maxeo/3dprint-sakura/README.md

# Sakura

Pannello decorativo 410 × 520 × 7 mm stampato in 3D, diviso in 6 moduli uniti da 21 perni Ø3,42 mm.

**Guida di stampa e montaggio:** https://maxeo.github.io/3dprint-guide/sakura/guida.html

La guida online è una copia pubblica di [guida.html](guida.html), pubblicata dal repo
[3dprint-guide](https://github.com/maxeo/3dprint-guide).

## Contenuto

- `guida.html`, `documenti/LEGGIMI_STAMPA_E_MONTAGGIO.txt`, `documenti/mappa_montaggio.svg`: istruzioni e impostazioni di stampa
- `dati/guida_spec.json`: sorgente di `guida.html`, da rigenerare con `build_guide.py` della skill guida-stampa-3d
- `stl/P01`…`P06_*_7mm.stl`: moduli, una copia ciascuno
- `stl/PERNO_D3.42_L15_stampare_21_copie.stl`: perno, 21 copie (in `stl/` anche le varianti Ø3,45–3,55)
- `prove/`: provini e giunto usati per tarare le sedi
- `originale/`: pannello intero prima della divisione
