maxeo/3dprint-sakura/originale/scaffale_sakura_ricreato_410x520x10mm.stl

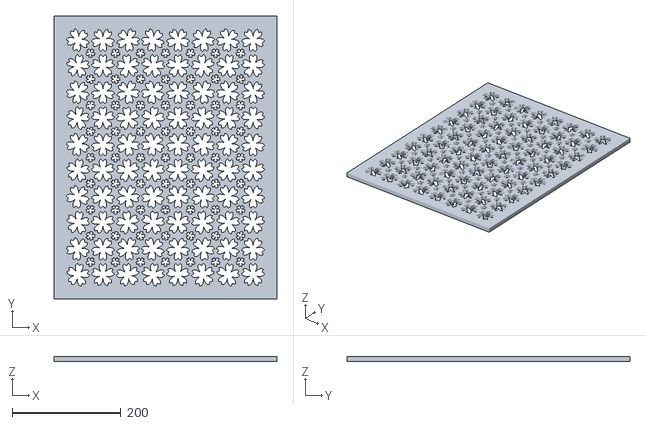
[picture p1: CAD file, 2026-09-12]
originale/scaffale_sakura_ricreato_410x520x10mm.stl
410.0 x 520.0 x 10.0
