maxeo/3dprint-sakura/prove/Sakura_provino_A_chiuso_H10_D605.stl

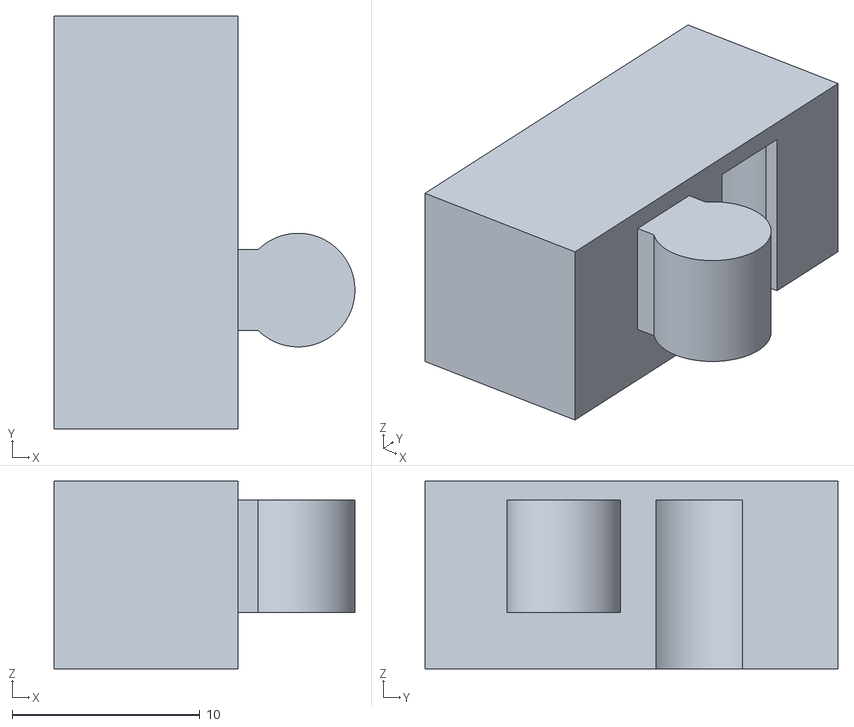
[picture p2: CAD file, 2026-09-12]
prove/Sakura_provino_A_chiuso_H10_D605.stl
16.0 x 22.0 x 10.0
