maxeo/3dprint-sakura/stl/PERNO_D3.55_L15_stampare_21_copie.stl

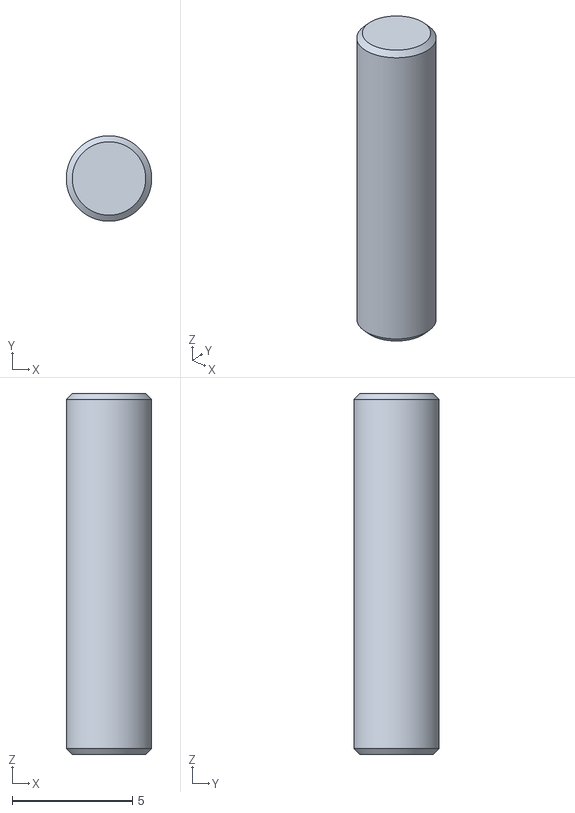
[picture p3: CAD file, 2026-09-26]
stl/PERNO_D3.55_L15_stampare_21_copie.stl
3.55 x 3.55 x 15.0
