maxeo/3dprint-sakura/prove/Sakura_giunto_2cubi10_perno_D3_L15.stl

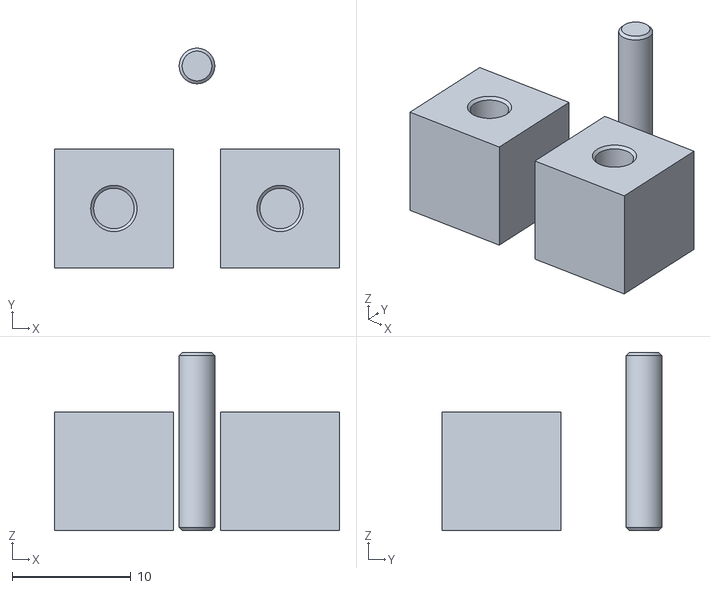
[picture p4: CAD file, 2026-09-12]
prove/Sakura_giunto_2cubi10_perno_D3_L15.stl
24.0 x 18.5 x 15.0
