maxeo/3dprint-sakura/stl/PERNO_D3.42_L15_stampare_21_copie.stl

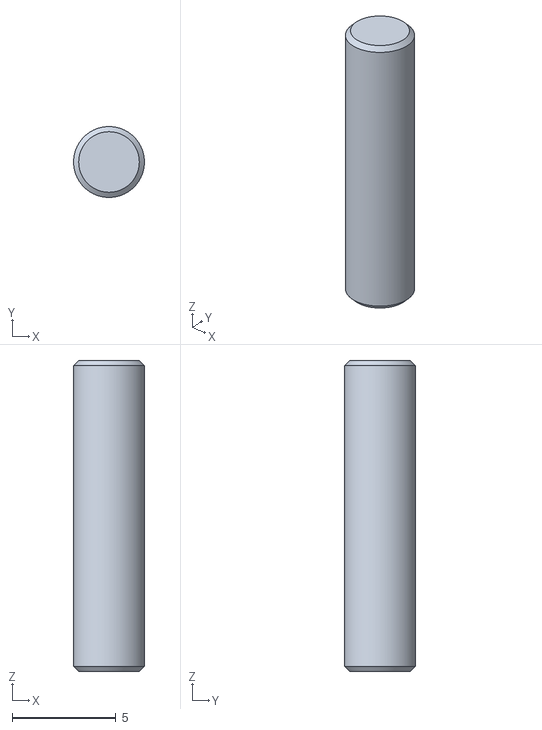
[picture p5: CAD file, 2026-09-13]
stl/PERNO_D3.42_L15_stampare_21_copie.stl
3.42 x 3.42 x 15.0
