maxeo/3dprint-sakura/stl/P03_205x174x7mm.stl

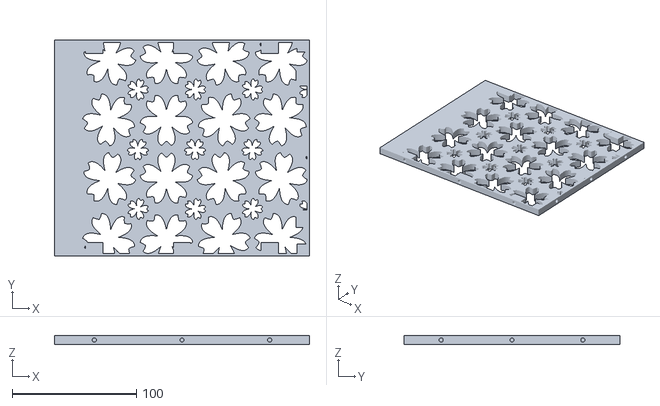
[picture p7: CAD file, 2026-09-13]
stl/P03_205x174x7mm.stl
205.0 x 174.0 x 7.00
