maxeo/3dprint-sakura/(list of files, cad)

Other CAD files:
prove/Sakura_provino_B_chiuso_H10_D605.stl
stl/PERNO_D3.45_L15_stampare_21_copie.stl
stl/PERNO_D3.50_L15_stampare_21_copie.stl
stl/P05_205x174x7mm.stl
stl/P04_205x174x7mm.stl
stl/P02_205x172x7mm.stl
stl/P01_205x172x7mm.stl
