maxeo/3dprint-sakura/(commit log)

2026-09-13 Aggiunti moduli Sakura da 7 mm e perni allargati
    - Ridotto lo spessore dei 6 moduli da 10 a 7 mm senza deformare le sedi
    - Ricentrate le sedi dei perni a Z=3,5 mantenendo D3,4 e profondità 7,5
    - Aggiunte tre varianti di perno L15 con diametro 3,15, 3,20 e 3,25
    - Aggiornati LEGGIMI e mappa di montaggio nella nuova cartella
    [P01_205x172x7mm.stl, P02_205x172x7mm.stl, P03_205x174x7mm.stl, P04_205x174x7mm.stl, P05_205x174x7mm.stl, P06_205x174x7mm.stl, PERNO_D3.15_L15.stl, PERNO_D3.20_L15.stl]
2026-09-13 Sostituiti i perni di prova con il perno definitivo D3,42
    - Aggiunto perno D3,42 x L15 da stampare in 21 copie
    - Rimosse le varianti D3,15, D3,20 e D3,25, risultate troppo lente
    - Aggiornato il LEGGIMI con il perno scelto e l'esito delle prove
    [PERNO_D3.15_L15.stl, PERNO_D3.20_L15.stl, PERNO_D3.25_L15.stl, PERNO_D3.42_L15_stampare_21_copie.stl]
2026-09-13 Riorganizzato il progetto sulla versione da 7 mm
    - Rimossa la vecchia versione dei moduli da 10 mm
    - Spostati nella cartella principale STL, guida e mappa da 7 mm
    - Spostati provini e giunto di prova nella cartella prove
    - Spostato il pannello intero ricreato nella cartella originale
    - Aggiunta la guida HTML di stampa e montaggio
    - Aggiornate le impostazioni di stampa dei moduli
    [P01_205x172x10mm.stl, P01_205x172x7mm.stl, P02_205x172x10mm.stl, P02_205x172x7mm.stl, P03_205x174x10mm.stl, P03_205x174x7mm.stl, P04_205x174x10mm.stl, P04_205x174x7mm.stl]
2026-09-13 Aggiunto il README con il link alla guida online
    - Aggiunto il collegamento alla guida pubblicata su GitHub Pages
    - Descritti i contenuti delle cartelle del progetto
2026-09-26 Riorganizzati i file del progetto in cartelle
    - Spostati gli STL in stl e i documenti in documenti
    - Aggiunti i perni di prova da 3,45 e 3,50 mm
    - Aggiornati i percorsi in guida e README
    [P01_205x172x7mm.stl, P02_205x172x7mm.stl, P03_205x174x7mm.stl, P04_205x174x7mm.stl, P05_205x174x7mm.stl, P06_205x174x7mm.stl, PERNO_D3.42_L15_stampare_21_copie.stl, PERNO_D3.45_L15_stampare_21_copie.stl]
2026-09-26 Aggiunto il tema chiaro e scuro alla guida
    - Pulsante Sistema, Chiaro, Scuro con scelta condivisa tra le guide
2026-09-27 Rigenerata la guida con il builder attuale
    - Aggiunto dati/guida_spec.json con testi, passaggi, parametri e note della guida precedente
    - La guida ha ora tema chiaro/scuro e pulsante Stampante con avviso sui pezzi che non entrano
    - Perni e giunti ricavati dalle sedi degli STL: 21 perni, 7 giunti
2026-09-27 Aggiornato il controllo della stampante nella guida
    - Letti anche i pezzi con dimensions_mm
2026-09-27 Aggiunta la ricerca delle stampanti nella guida
    - Elenco di ~390 stampanti dai profili OrcaSlicer, con parole evidenziate
    - Pulsanti in cima alla pagina su mobile e margine sotto l'avviso
2026-09-27 Aggiunto sfondo chiaro agli schemi nel tema scuro
    - Schemi delle note leggibili anche con il tema scuro
2026-09-27 Resa leggibile la riga selezionata nel tema scuro
    - Riga selezionata della lista di stampa con sfondo scuro
